smotesko/power-kit-PSU/README.md

Isolated switch mode power supply for Eurorack synth, ±12V and +5V outputs

See [posts tagged "power-kit"](https://smotesko.com/tags#power-kit) for details.
