smotesko/power-kit-PSU/BOM.md

| References | Quantity | Description | Value | Part number | Mouser part number |
|---|---|---|---|---|---|
| C1, C2, C4, C5, C10 | 5 | Capacitor ceramic, X7R, SMD 0805 | 1uF | GCM21BR71H105KA03L | 81-GCM21BR71H105KA3L |
| C6, C7, C11 | 3 | Capacitor tantalum, SMD size B (3528) | 10uF | T521T106M025ATE060 | 80-T521T106M025ATE60 |
| C3 | 1 | Capacitor electrolytic, thru-hole | 47uF | EEU-FC1H470 | 667-EEU-FC1H470 |
| CON1 | 1 | DC Barrel Jack | | CON-SOCJ-2155 | 992-CON-SOCJ-2155 |
| D4 | 1 | Diode, zener | 10V | 1N5240BTR | 512-1N5240BTR |
| D3 | 1 | LED 3mm red 5V | | HLMP-1600 | 630-HLMP-1600 |
| D1, D2 | 2 | LED 3mm green 12V | | HLMP-1641 | 630-HLMP-1641 |
| P1 | 1 | Terminal block, 2 pos. | | 1984617 | 651-1984617 |
| P2 | 1 | Terminal block, 6 pos. | | 1984659 | 651-1984659 |
| Q1 | 1 | Transistor P-MOSFET | | IRF4905PBF | 942-IRF4905PBF |
| R1 | 1 | Resistor | 100k | | |
| U1 | 1 | DC-DC converter module | | NCS12D1212C | 580-NCS12D1212C |
| U2 | 1 | DC-DC converter module | | NCS12S1205C | 580-NCS12S1205C |
| | | | | | |
| **Input  filtering – optional components:** | | | | | |
| L1 | 1 | Common-mode choke | 1.0mH 3.3A | 51105C | 580-51105C |
| C8, C9 | 2 | Capacitor Y-rated 250V | 10nF | | |
