smotesko/power-kit-PSU/power-kit.rev1.pdf

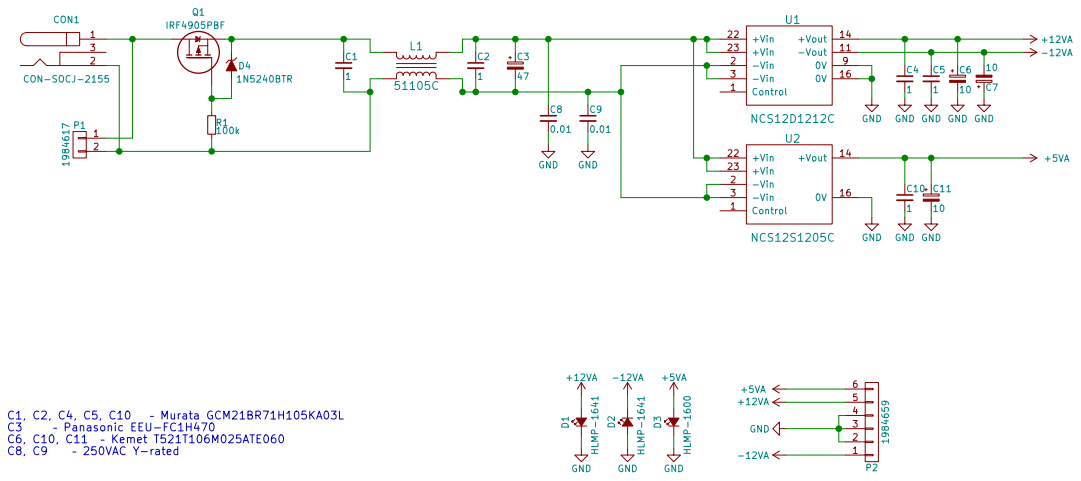
[picture p1: page 1]

10 GND GND GND GND GND

File: power-kit.sch Sheet: /
Id: 1/1 Title:
