smotesko/power-kit-PSU/power-kit.kicad_pcb

## KiCad design power-kit.kicad_pcb (2017-09-03)

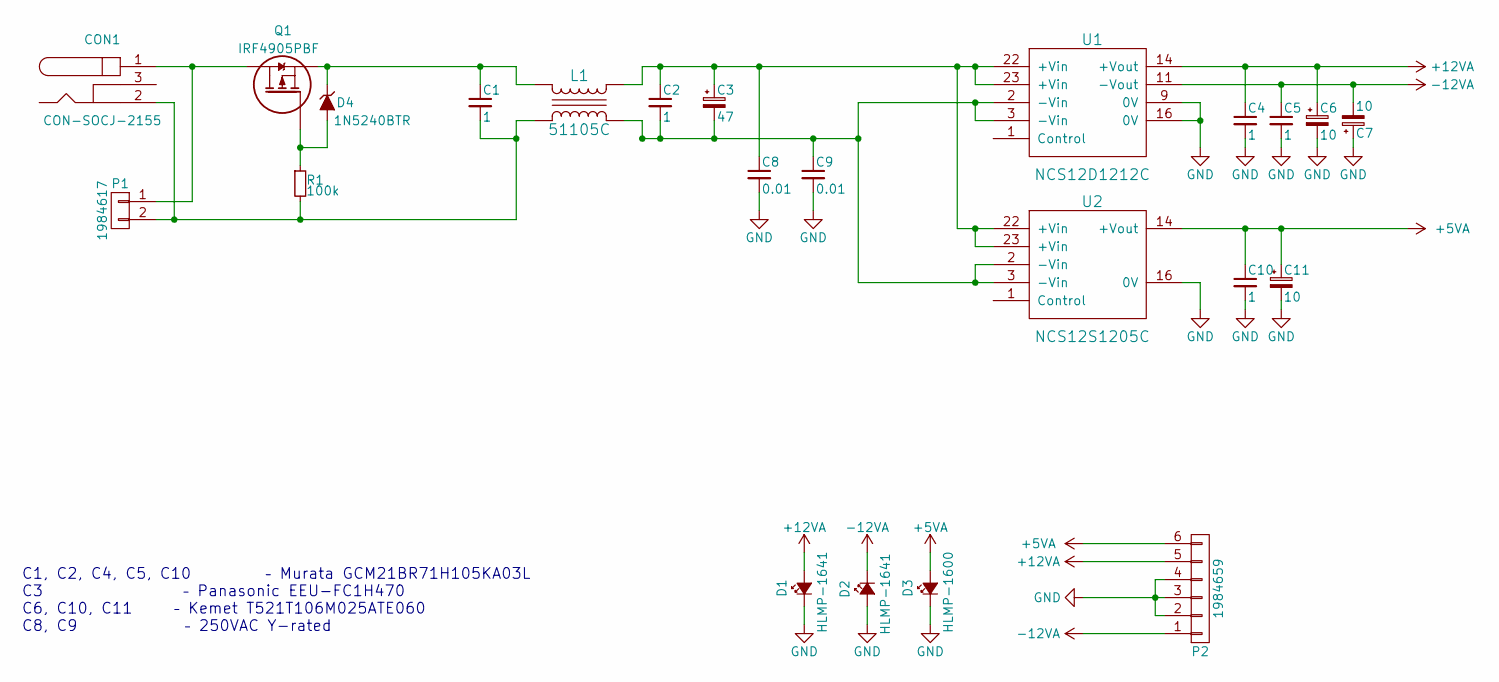
[picture p2: schematic power-kit.sch]

Parts:
C1, C2, C4, C5, C10: 1; C_0805_HandSoldering
C3: 47; C_Radial_D6.3_L11.2_P2.5
C6, C7, C11: 10; TantalC_SizeB_EIA-3528_HandSoldering
C8, C9: 0.01; CAP_TH_Radial_15x5_7.5mm
CON1: CON-SOCJ-2155; BARREL_JACK
D1, D2: HLMP-1641; LED-3MM
D3: HLMP-1600; LED-3MM
D4: 1N5240BTR; Diode_DO-35_SOD27_Horizontal_RM10
L1: 51105C; Murata_inductor_5100_series
P1: 1984617; TerminalBlock_Pheonix_PT-3.5mm_2pol
P2: 1984659; TerminalBlock_Pheonix_PT-3.5mm_6pol
Q1: IRF4905PBF; TO-220_Neutral123_Vertical
R1: 100k; Resistor_Horizontal_RM10mm
U1: NCS12D1212C; Murata_NCS12_DC-DC
U2: NCS12S1205C; Murata_NCS12_DC-DC

Connections:
+5VA: C10.1, C11.1, D3.2 (A), P2.6, U2.14 (+Vout)
+12VA: C4.1, C6.1, D1.2 (A), P2.5, U1.14 (+Vout)
-12VA: C5.1, C7.2, D2.1 (K), P2.1, U1.11 (-Vout)
GND: C4.2, C5.2, C6.2, C7.1, C8.2, C9.2, C10.2, C11.2, D1.1 (K), D2.2 (A), D3.1 (K), P2.2, P2.3, P2.4, U1.9 (0V), U1.16 (0V), U2.16 (0V)
unnamed: C1.1, D4.1 (K), L1.4, Q1.3 (S)
unnamed: C1.2, CON1.2, L1.3, P1.2, R1.2
unnamed: C2.1, C3.1, C8.1, L1.1, U1.22 (+Vin), U1.23 (+Vin), U2.22 (+Vin), U2.23 (+Vin)
unnamed: C2.2, C3.2, C9.1, L1.2, U1.2 (-Vin), U1.3 (-Vin), U2.2 (-Vin), U2.3 (-Vin)
unnamed: CON1.1, P1.1, Q1.2 (D)
unnamed: D4.2 (A), Q1.1 (G), R1.1

Notes on the sheet:
C1, C2, C4, C5, C10 – Murata GCM21BR71H105KA03L C3 – Panasonic EEU-FC1H470 C6, C10, C11 – Kemet T521T106M025ATE060 C8, C9 – 250VAC Y-rated

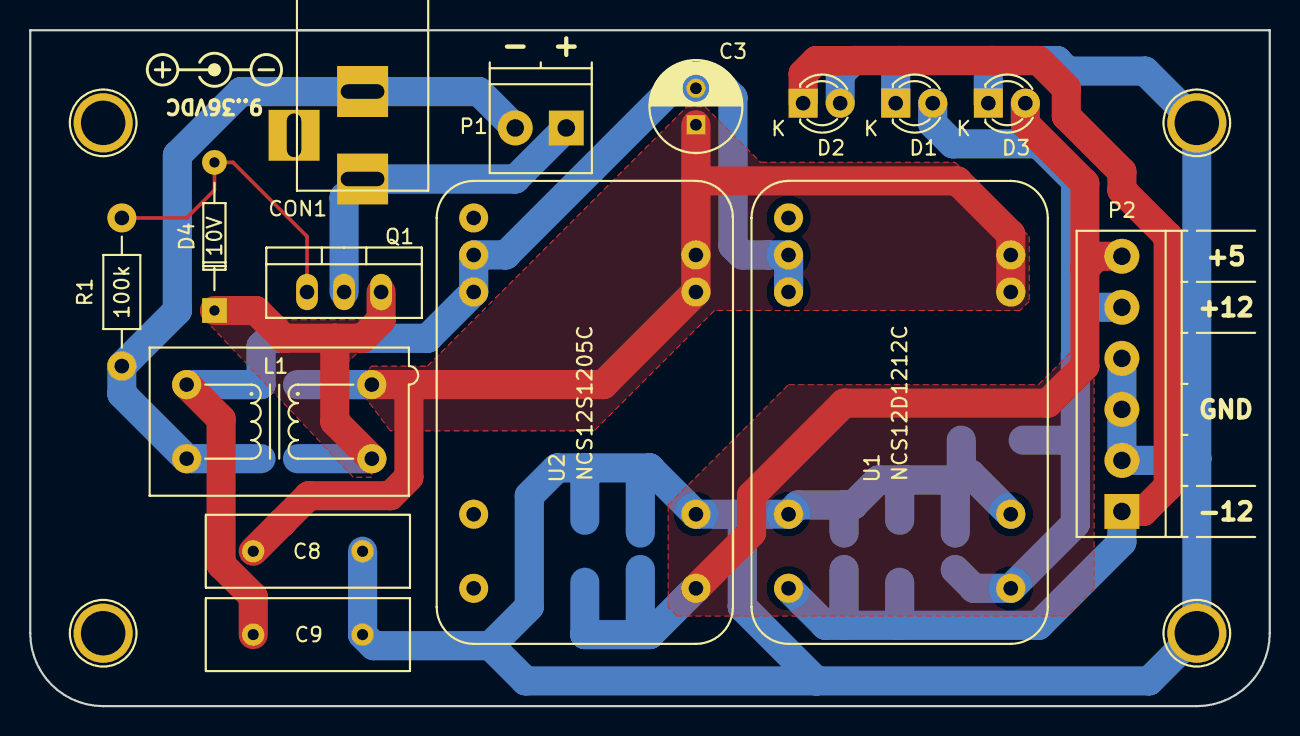
[picture p3: board power-kit.kicad_pcb from above]

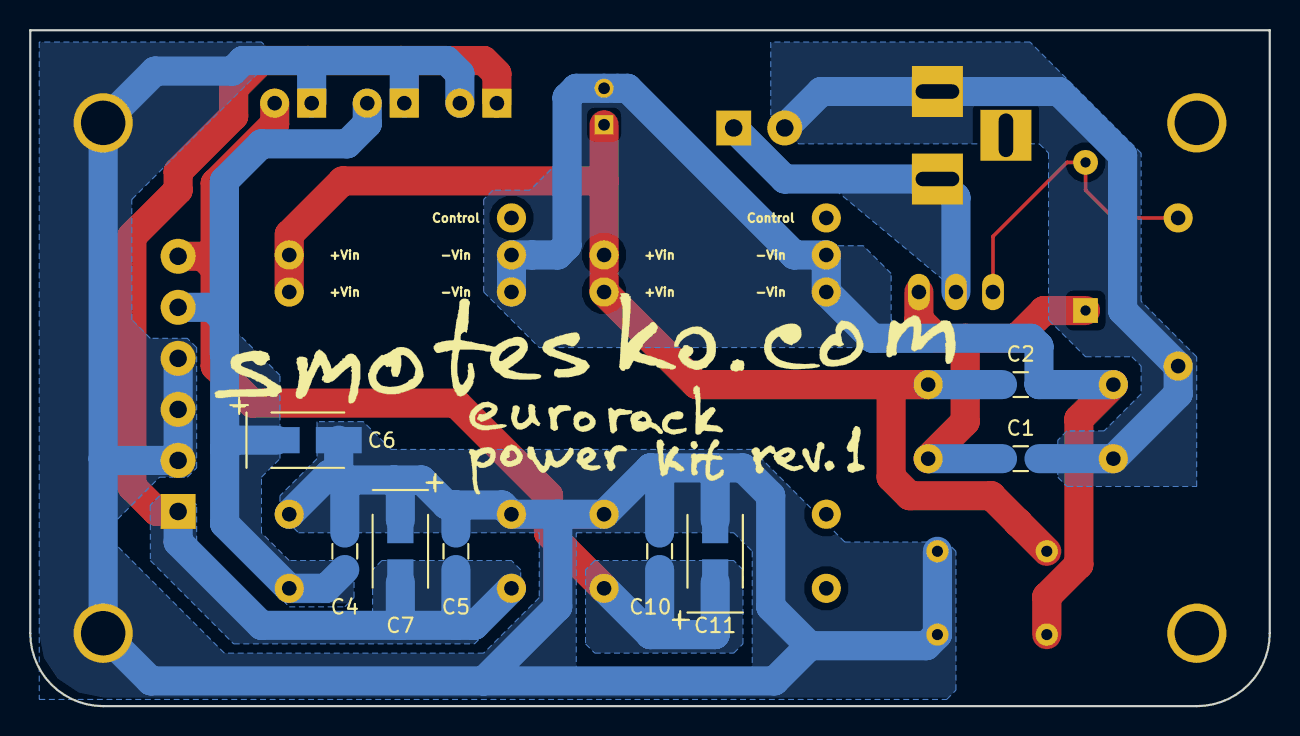
[picture p4: board power-kit.kicad_pcb from below]

Board: 2 copper layers, 85.0 x 46.3 mm, 23 parts (8 on the bottom side), 10 nets.
